ChuckTimber/SWer4x4/README.md

# SWer4x4

[3ループ・スイッチャ - DIY Fx and Synthesizer](https://scrapbox.io/diyfx/3%E3%83%AB%E3%83%BC%E3%83%97%E3%83%BB%E3%82%B9%E3%82%A4%E3%83%83%E3%83%81%E3%83%A3)

## 仕様

## 回路図

## 筐体
### テストベッド
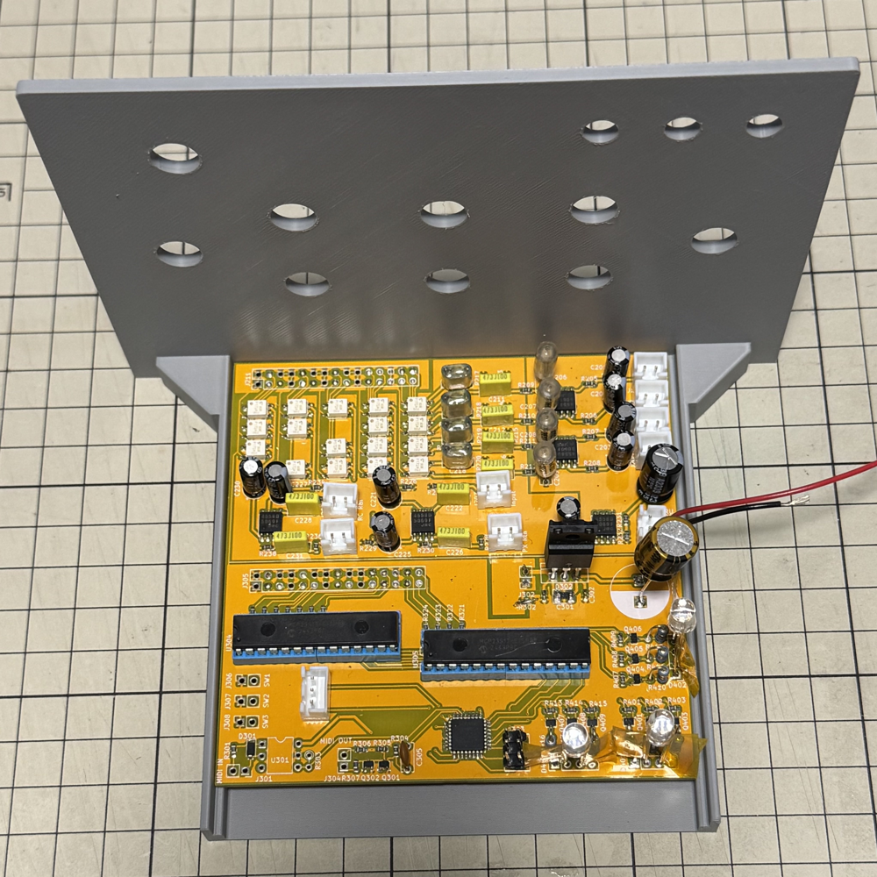
[picture p1: rsrc/testbed.png]
