ChuckTimber/SWer4x4/hardware/Enclosure/testbed/testbed_v2.FCStd

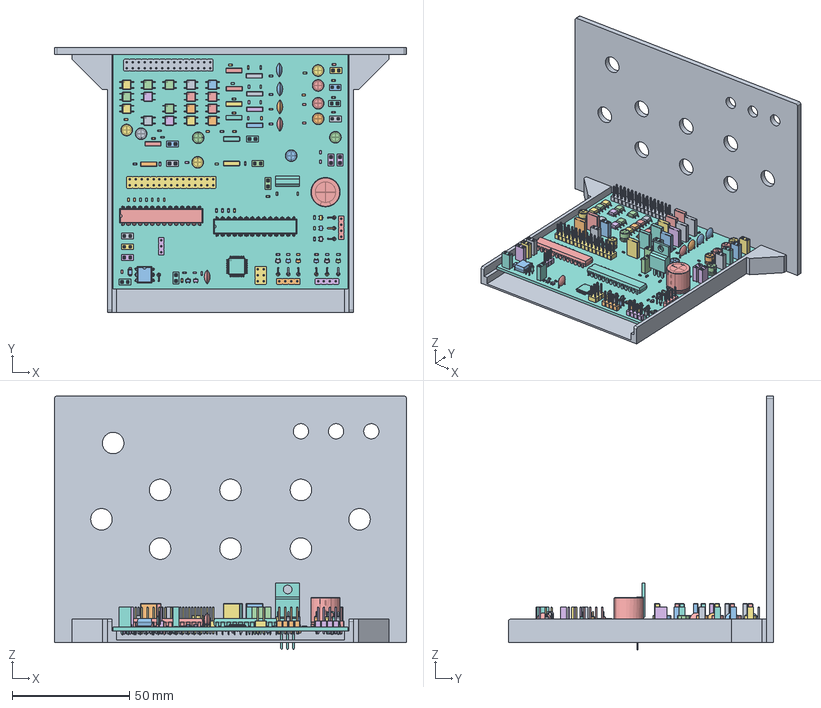
[picture p2: CAD file, 2026-01-19]
hardware/Enclosure/testbed/testbed_v2.FCStd
150.0 x 113.0 x 108.2 mm
R_0603_1608Metric
SOT-323_SC-70
R_0603_1608Metric001
CP_Radial_D12.5mm_P5.00mm
R_0603_1608Metric002
SOP-4_3.8x4.1mm_P2.54mm
PinSocket_1x02_P2.54mm_Vertical
R_0603_1608Metric003
C_Rect_L7.0mm_W2.0mm_P5.00mm
SOT-323_SC-071
SOP-4_3.8x4.1mm_P2.54mm001
C_Rect_L7.0mm_W2.0mm_P5.00mm001
R_0603_1608Metric004
R_Axial_DIN0204_L3.6mm_D1.6mm_P2.54mm_Vertical
R_Axial_DIN0204_L3.6mm_D1.6mm_P2.54mm_Vertical001
R_0603_1608Metric005
CP_Radial_D5.0mm_P2.00mm
R_0603_1608Metric006
SOT-323_SC-072
R_0603_1608Metric007
R_0603_1608Metric008
CP_Radial_D5.0mm_P2.00mm001
C_Rect_L7.0mm_W2.0mm_P5.00mm002
SOP-4_3.8x4.1mm_P2.54mm002
SOT-323_SC-073
R_Axial_DIN0204_L3.6mm_D1.6mm_P2.54mm_Vertical002
R_0603_1608Metric009
CP_Radial_D5.0mm_P2.00mm002
PinHeader_1x03_P2.54mm_Vertical
PinSocket_1x02_P2.54mm_Vertical001
R_0603_1608Metric010
R_0603_1608Metric011
R_0603_1608Metric012
C_Rect_L7.0mm_W2.0mm_P5.00mm003
R_0603_1608Metric013
C_Disc_D6.0mm_W2.5mm_P5.00mm
R_0603_1608Metric014
R_Axial_DIN0204_L3.6mm_D1.6mm_P2.54mm_Vertical003
PinSocket_1x02_P2.54mm_Vertical002
R_Axial_DIN0204_L3.6mm_D1.6mm_P2.54mm_Vertical004
C_Disc_D6.0mm_W2.5mm_P5.00mm001
SWer_matrix 1.42.1
SWer_matrix 1.42.002
SWer_matrix 1.42.003
SWer_matrix 1.42.004
R_0603_1608Metric015
R_0603_1608Metric016
C_Rect_L7.0mm_W2.0mm_P5.00mm004
R_0603_1608Metric017
R_0603_1608Metric018
PinSocket_1x02_P2.54mm_Vertical003
C_Rect_L7.0mm_W2.0mm_P5.00mm005
R_0603_1608Metric019
PinHeader_2x03_P2.54mm_Vertical
TQFP-32_7x7mm_P0.8mm
CP_Radial_D5.0mm_P2.00mm003
R_0603_1608Metric020
R_0603_1608Metric021
CP_Radial_D5.0mm_P2.00mm004
C_Rect_L7.0mm_W2.0mm_P5.00mm006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
