ChuckTimber/SWer4x4/hardware/Enclosure/testbed/testbed_v2-Body.3mf

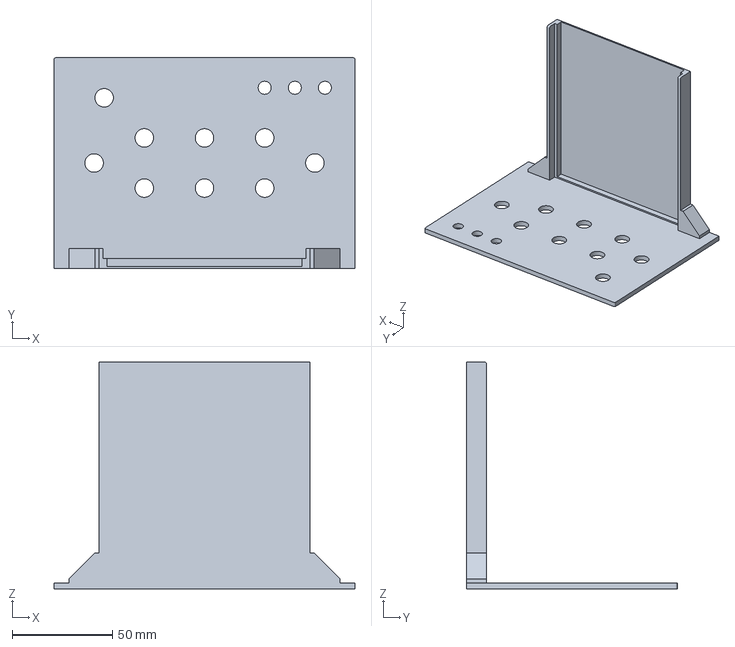
[picture p3: CAD file, 2026-01-19]
hardware/Enclosure/testbed/testbed_v2-Body.3mf
150.0 x 105.0 x 113.0 mm
