ChuckTimber/SWer4x4/(list of files, cad)

Other CAD files:
hardware/Enclosure/testbed/testbed_v2-Body.stl
