ChuckTimber/SWer4x4/hardware/SWer_matrix.pdf

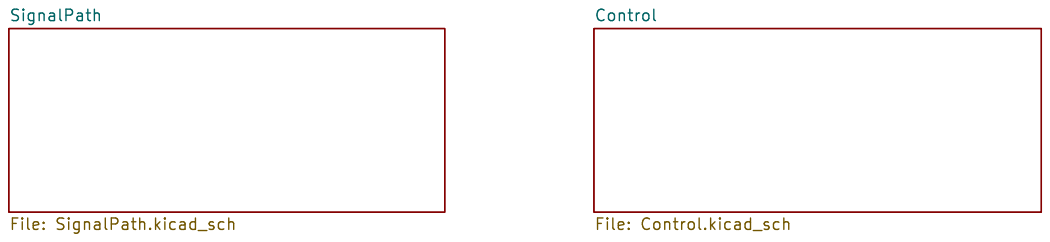
[picture p4: page 1]

Control File: Control.kicad_sch SignalPath File: SignalPath.kicad_sch

Id: 1/4 Title: Swticher Matrix 4x4

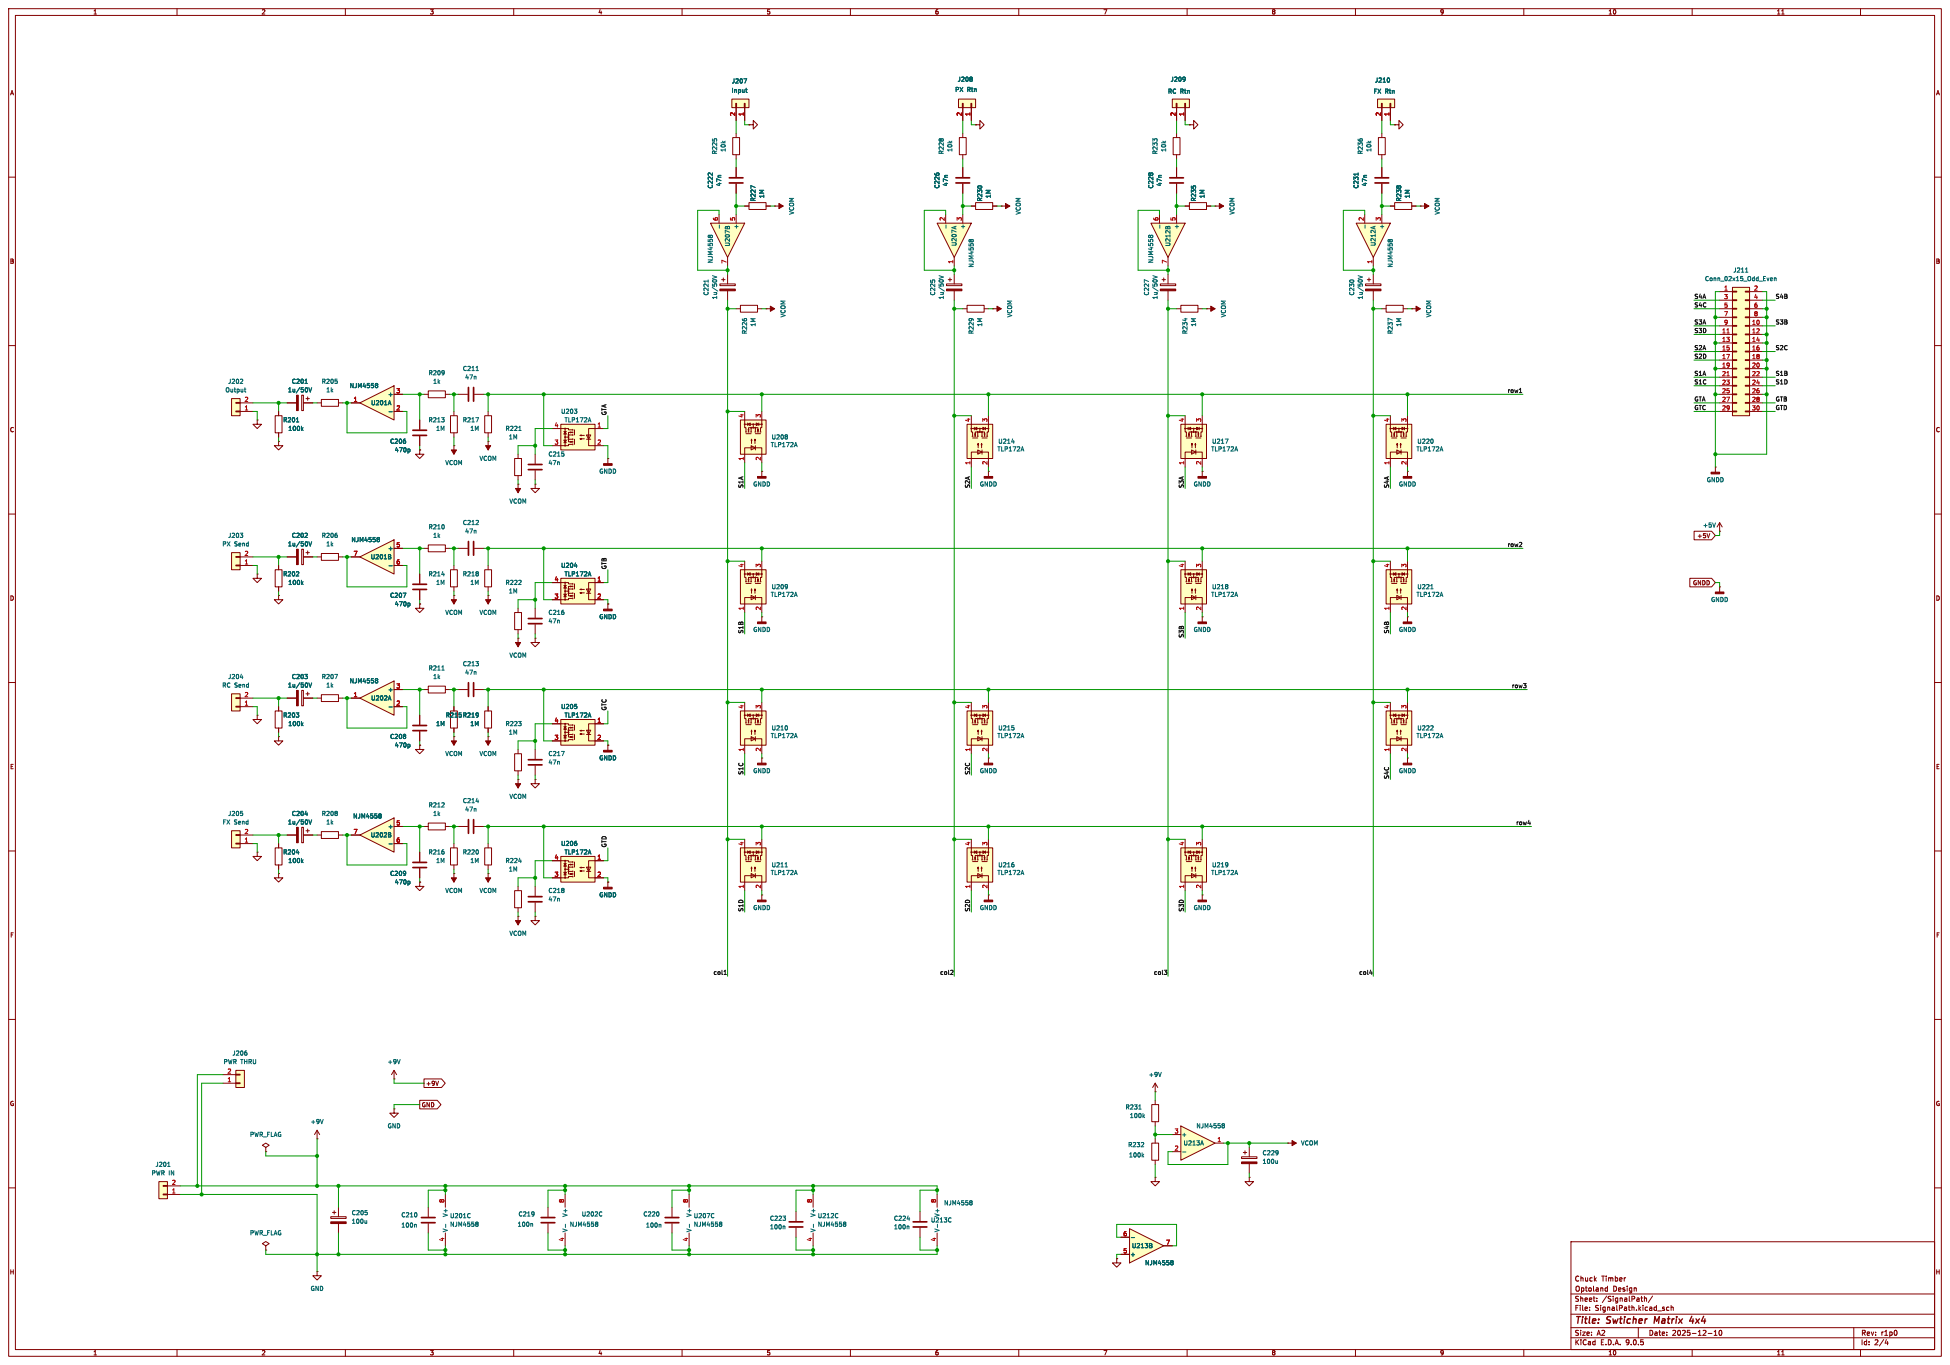
[picture p5: page 2]

File: SignalPath.kicad_sch Sheet: /SignalPath/

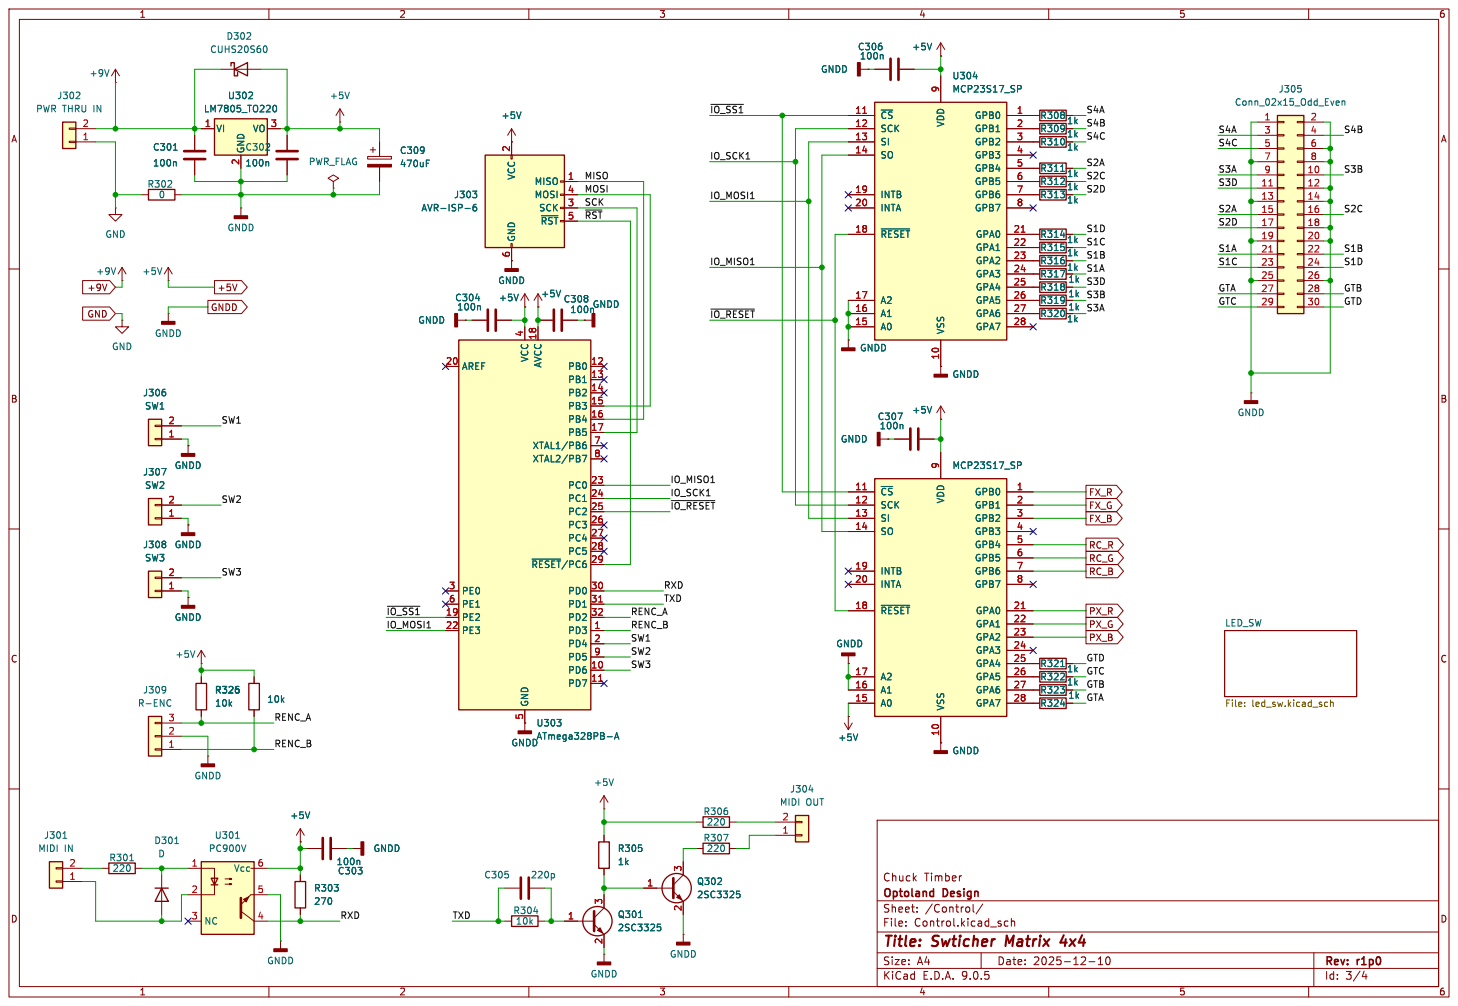
[picture p6: page 3]

6 MISO 1 MOSI 4 SCK 3 ~{RST}5 +5V C302

6 MISO 1 MOSI 4 SCK 3 ~{RST}5

5 AVCC 18 PB0 12 PB1 13 PB2 14 PB3 15 PB4 16 PB5 17 XTAL1/PB6 7 XTAL2/PB7 8 PC0 23 PC1 24 PC2 25 PC3 26 PC4 27 PC5 28 ~{RESET}/PC629 PD0 30 PD1 31 PD2 32 PD3 1 PD4 2 PD5 9 PD6 10 PD7 11 GNDD GNDD C308

Id: 3/4 Title: Swticher Matrix 4x4

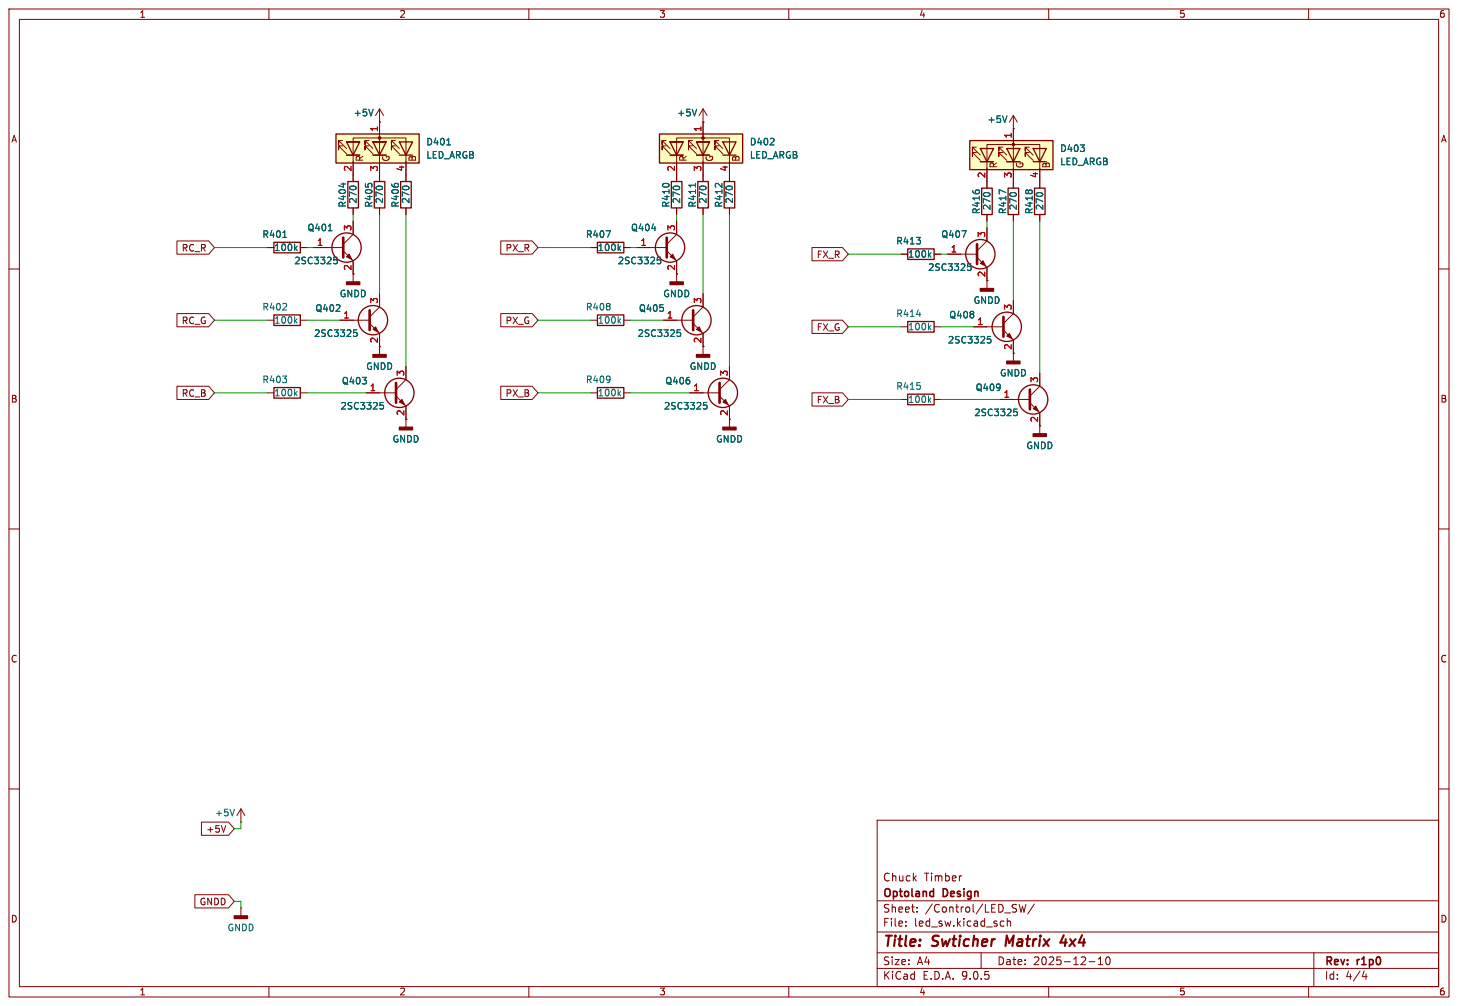
[picture p7: page 4]

File: led_sw.kicad_sch Sheet: /Control/LED_SW/
Id: 4/4 Title: Swticher Matrix 4x4
