ChuckTimber/SWer4x4/hardware/KiCAD/SWer_matrix.kicad_pcb

## KiCad design hardware/KiCAD/SWer_matrix.kicad_pcb (2026-01-19)

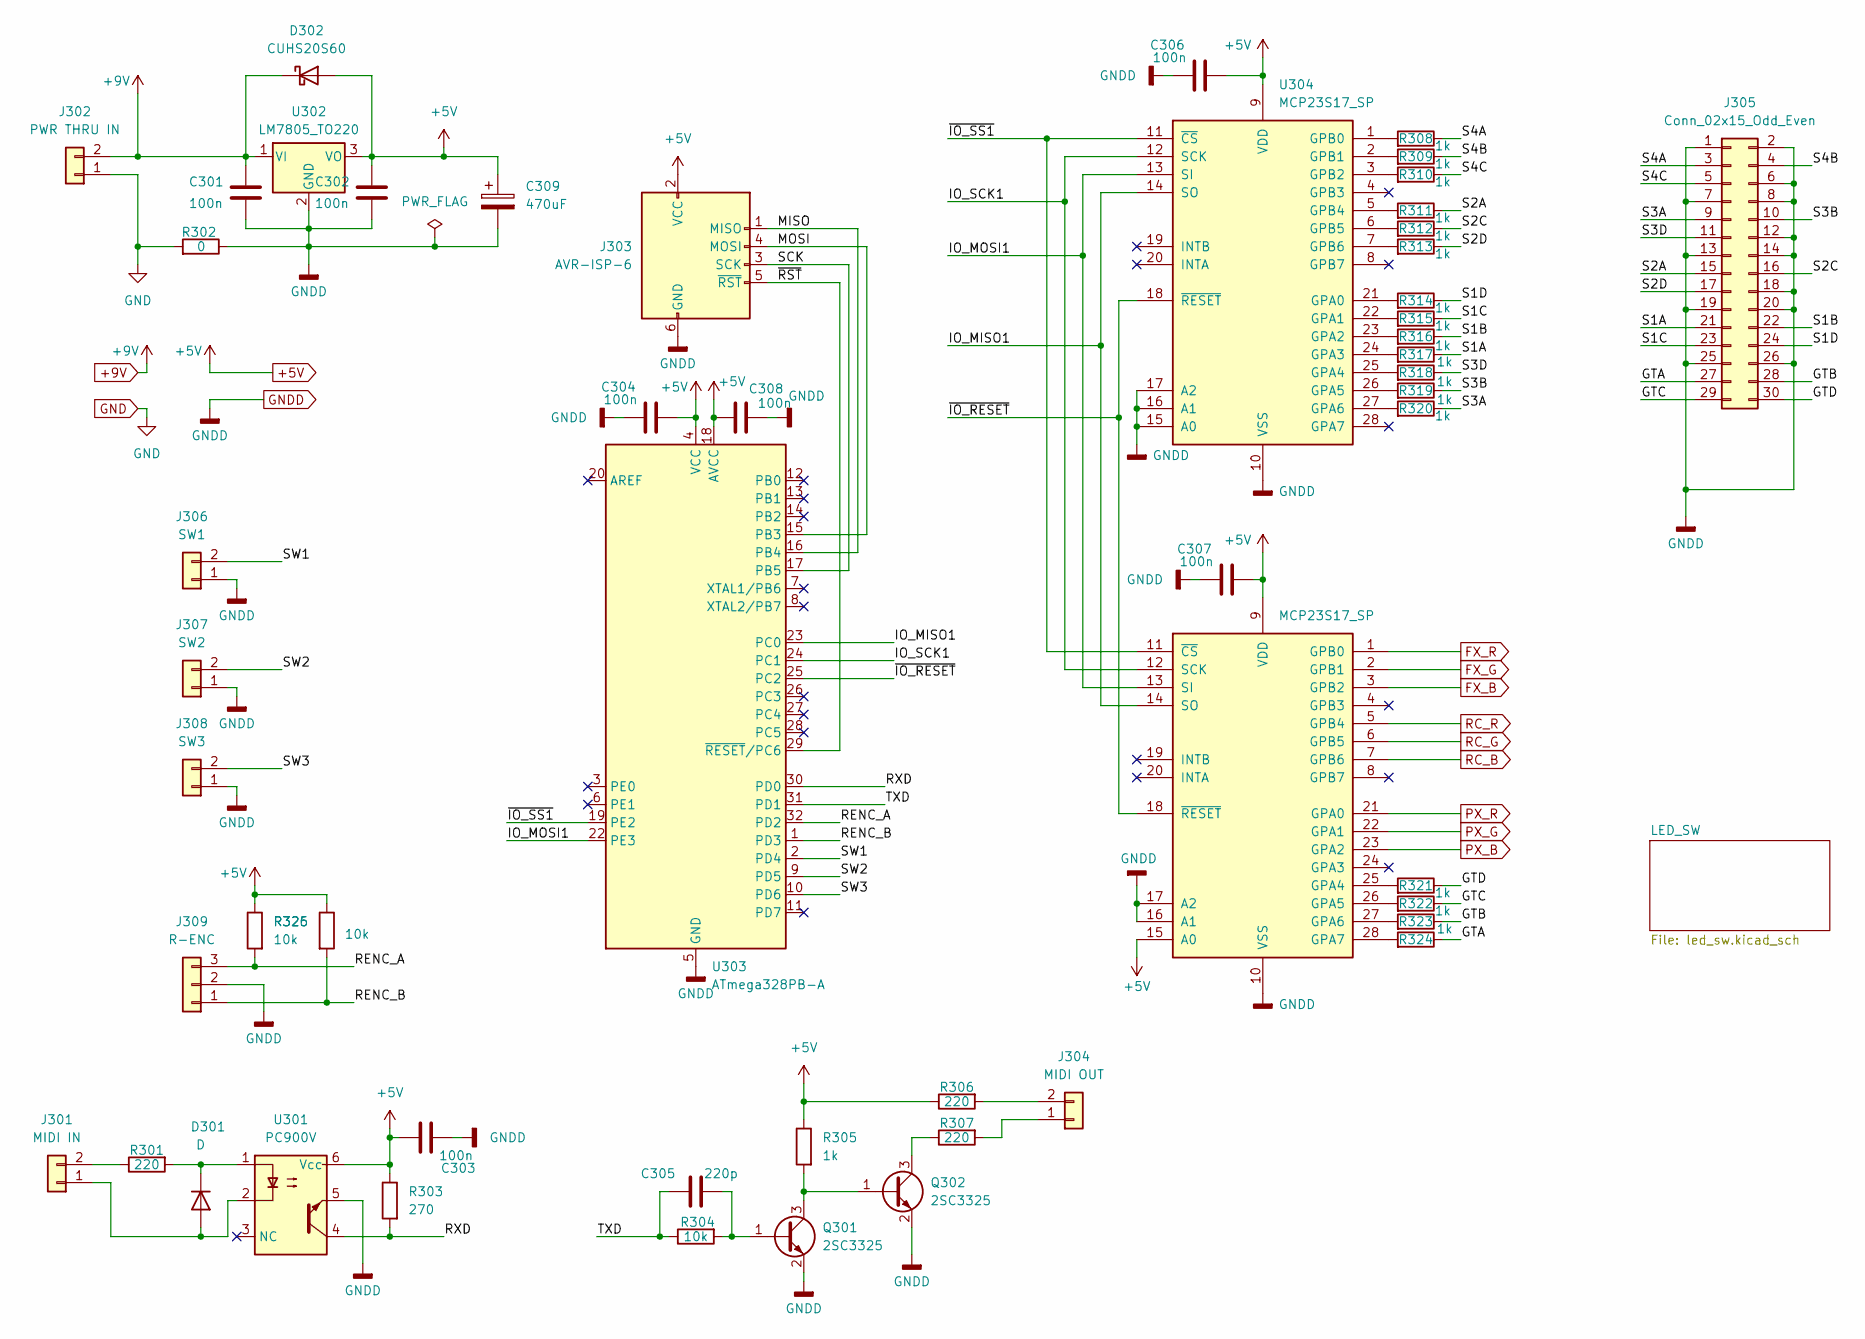
[picture p8: schematic Control.kicad_sch, Swticher Matrix 4x4]

Parts:
C301, C302, C303, C304, C306, C307, C308: 100n; C_0603_1608Metric_Pad1.08x0.95mm_HandSolder
C305: 220p; C_Disc_D6.0mm_W2.5mm_P5.00mm
C309: 470uF; CP_Radial_D12.5mm_P5.00mm
D301: D; Nexperia_CFP3_SOD-123W
D302: CUHS20S60; D_1210_3225Metric_Pad1.42x2.65mm_HandSolder
J301: MIDI IN; PinSocket_1x02_P2.54mm_Vertical
J302: PWR THRU IN; PinSocket_1x02_P2.54mm_Vertical
J303: AVR-ISP-6; PinHeader_2x03_P2.54mm_Vertical
J304: MIDI OUT; PinSocket_1x02_P2.54mm_Vertical
J305: Conn_02x15_Odd_Even; PinHeader_2x15_P2.54mm_Vertical
J306: SW1; PinSocket_1x02_P2.54mm_Vertical
J307: SW2; PinSocket_1x02_P2.54mm_Vertical
J308: SW3; PinSocket_1x02_P2.54mm_Vertical
J309: R-ENC; PinHeader_1x03_P2.54mm_Vertical
Q301, Q302: 2SC3325; SOT-323_SC-70
R301, R306, R307: 220; R_0603_1608Metric_Pad0.98x0.95mm_HandSolder
R302: 0; R_0603_1608Metric_Pad0.98x0.95mm_HandSolder
R303: 270; R_Axial_DIN0204_L3.6mm_D1.6mm_P2.54mm_Vertical
R304, R325, R326: 10k; R_0603_1608Metric_Pad0.98x0.95mm_HandSolder
R305, R308, R309, R310, R311, R312, R313, R314, R315, R316, R317, R318, R319, R320, R321, R322, R323, R324: 1k; R_0603_1608Metric_Pad0.98x0.95mm_HandSolder
U301: PC900V; DIP-6_W7.62mm
U302: LM7805_TO220; TO-220-3_Vertical
U303: ATmega328PB-A; TQFP-32_7x7mm_P0.8mm
U304, U305: MCP23S17_SP; DIP-28_W7.62mm

Connections:
+5V: C302.1, C303.2, C304.2, C306.2, C307.2, C308.2, C309.1, D302.2 (A), J303.2 (VCC), R303.1, R305.1, R306.1, R325.1, R326.1, U301.6 (Vcc), U302.3 (VO), U303.4 (VCC), U303.18 (AVCC), U304.9 (VDD), U305.9 (VDD), U305.15 (A0); also elsewhere on the board
+9V: C301.1, D302.1 (K), J302.2, U302.1 (VI); also elsewhere on the board
/Control/GTA: J305.27, R324.1
/Control/GTB: J305.28, R323.1
/Control/GTC: J305.29, R322.1
/Control/GTD: J305.30, R321.1
/Control/IO_MISO1: U303.23 (PC0), U304.14 (SO), U305.14 (SO)
/Control/IO_MOSI1: U303.22 (PE3), U304.13 (SI), U305.13 (SI)
/Control/IO_SCK1: U303.24 (PC1), U304.12 (SCK), U305.12 (SCK)
/Control/MISO: J303.1 (MISO), U303.16 (PB4)
/Control/MOSI: J303.4 (MOSI), U303.15 (PB3)
/Control/RENC_A: J309.3, R325.2, U303.32 (PD2)
/Control/RENC_B: J309.1, R326.2, U303.1 (PD3)
/Control/RXD: R303.2, U301.4, U303.30 (PD0)
/Control/S1A: J305.21, R317.1
/Control/S1B: J305.22, R316.1
/Control/S1C: J305.23, R315.1
/Control/S1D: J305.24, R314.1
/Control/S2A: J305.15, R311.1
/Control/S2C: J305.16, R312.1
/Control/S2D: J305.17, R313.1
/Control/S3A: J305.9, R320.1
/Control/S3B: J305.10, R319.1
/Control/S3D: J305.11, R318.1
/Control/S4A: J305.3, R308.1
/Control/S4B: J305.4, R309.1
/Control/S4C: J305.5, R310.1
/Control/SCK: J303.3 (SCK), U303.17 (PB5)
/Control/SW1: J306.2, U303.2 (PD4)
/Control/SW2: J307.2, U303.9 (PD5)
/Control/SW3: J308.2, U303.10 (PD6)
/Control/TXD: C305.1, R304.1, U303.31 (PD1)
/Control/~IO_RESET: U303.25 (PC2), U304.18 (~RESET), U305.18 (~RESET)
/Control/~IO_SS1: U303.19 (PE2), U304.11 (~CS), U305.11 (~CS)
/Control/~RST: J303.5 (~RST), U303.29 (~RESET/PC6)
FX_B: U305.3 (GPB2); also elsewhere on the board
FX_G: U305.2 (GPB1); also elsewhere on the board
FX_R: U305.1 (GPB0); also elsewhere on the board
GND: J302.1, R302.2; also elsewhere on the board
GNDD: C301.2, C302.2, C303.1, C304.1, C306.1, C307.1, C308.1, C309.2, J303.6 (GND), J305.1, J305.2, J305.6, J305.7, J305.8, J305.12, J305.13, J305.14, J305.18, J305.19, J305.20, J305.25, J305.26, J306.1, J307.1, J308.1, J309.2, Q301.2 (E), Q302.2 (E), R302.1, U301.5, U302.2 (GND), U303.5 (GND), U303.21 (GND), U304.10 (VSS), U304.15 (A0), U304.16 (A1), U304.17 (A2), U305.10 (VSS), U305.16 (A1), U305.17 (A2); also elsewhere on the board
unnamed: D301.2 (A), J301.1, U301.2
unnamed: D301.1 (K), R301.2, U301.1
unnamed: J301.2, R301.1
unnamed: J304.1, R307.2
unnamed: J304.2, R306.2
unnamed: C305.2, Q301.1 (B), R304.2
unnamed: Q301.3 (C), Q302.1 (B), R305.2
unnamed: Q302.3 (C), R307.1
unnamed: R314.2, U304.21 (GPA0)
unnamed: R315.2, U304.22 (GPA1)
unnamed: R316.2, U304.23 (GPA2)
unnamed: R317.2, U304.24 (GPA3)
unnamed: R318.2, U304.25 (GPA4)
unnamed: R319.2, U304.26 (GPA5)
unnamed: R320.2, U304.27 (GPA6)
unnamed: R308.2, U304.1 (GPB0)
unnamed: R309.2, U304.2 (GPB1)
unnamed: R310.2, U304.3 (GPB2)
unnamed: R311.2, U304.5 (GPB4)
unnamed: R312.2, U304.6 (GPB5)
unnamed: R313.2, U304.7 (GPB6)
unnamed: R321.2, U305.25 (GPA4)
unnamed: R322.2, U305.26 (GPA5)
unnamed: R323.2, U305.27 (GPA6)
unnamed: R324.2, U305.28 (GPA7)
PX_B: U305.23 (GPA2); also elsewhere on the board
PX_G: U305.22 (GPA1); also elsewhere on the board
PX_R: U305.21 (GPA0); also elsewhere on the board
RC_B: U305.7 (GPB6); also elsewhere on the board
RC_G: U305.6 (GPB5); also elsewhere on the board
RC_R: U305.5 (GPB4); also elsewhere on the board

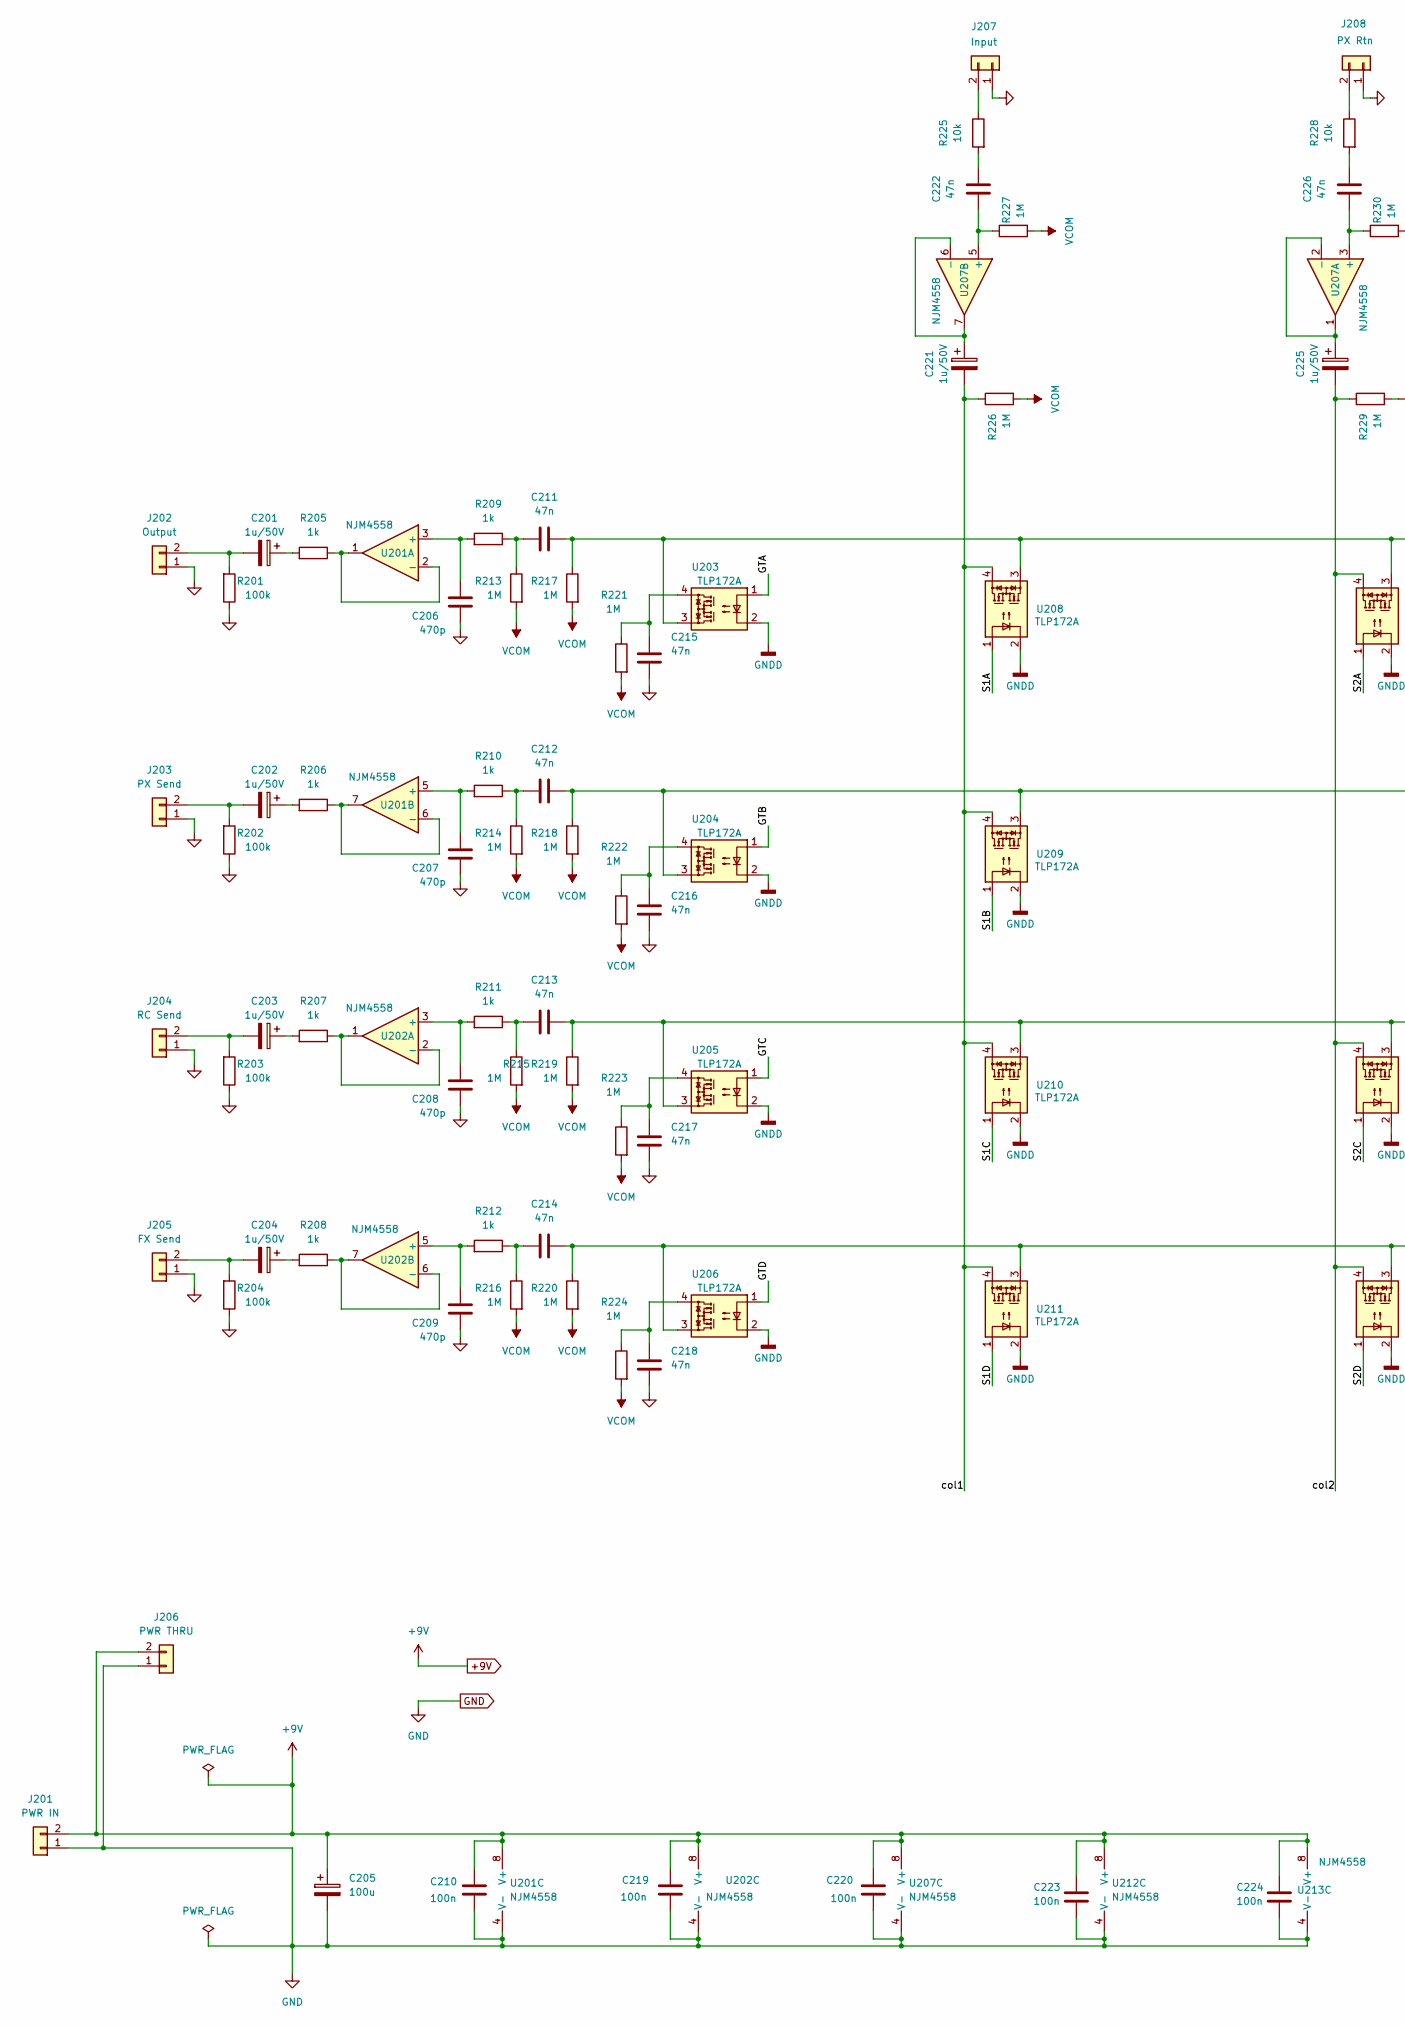
[picture p9: schematic SignalPath.kicad_sch, Swticher Matrix 4x4, part in row 1, column 1]

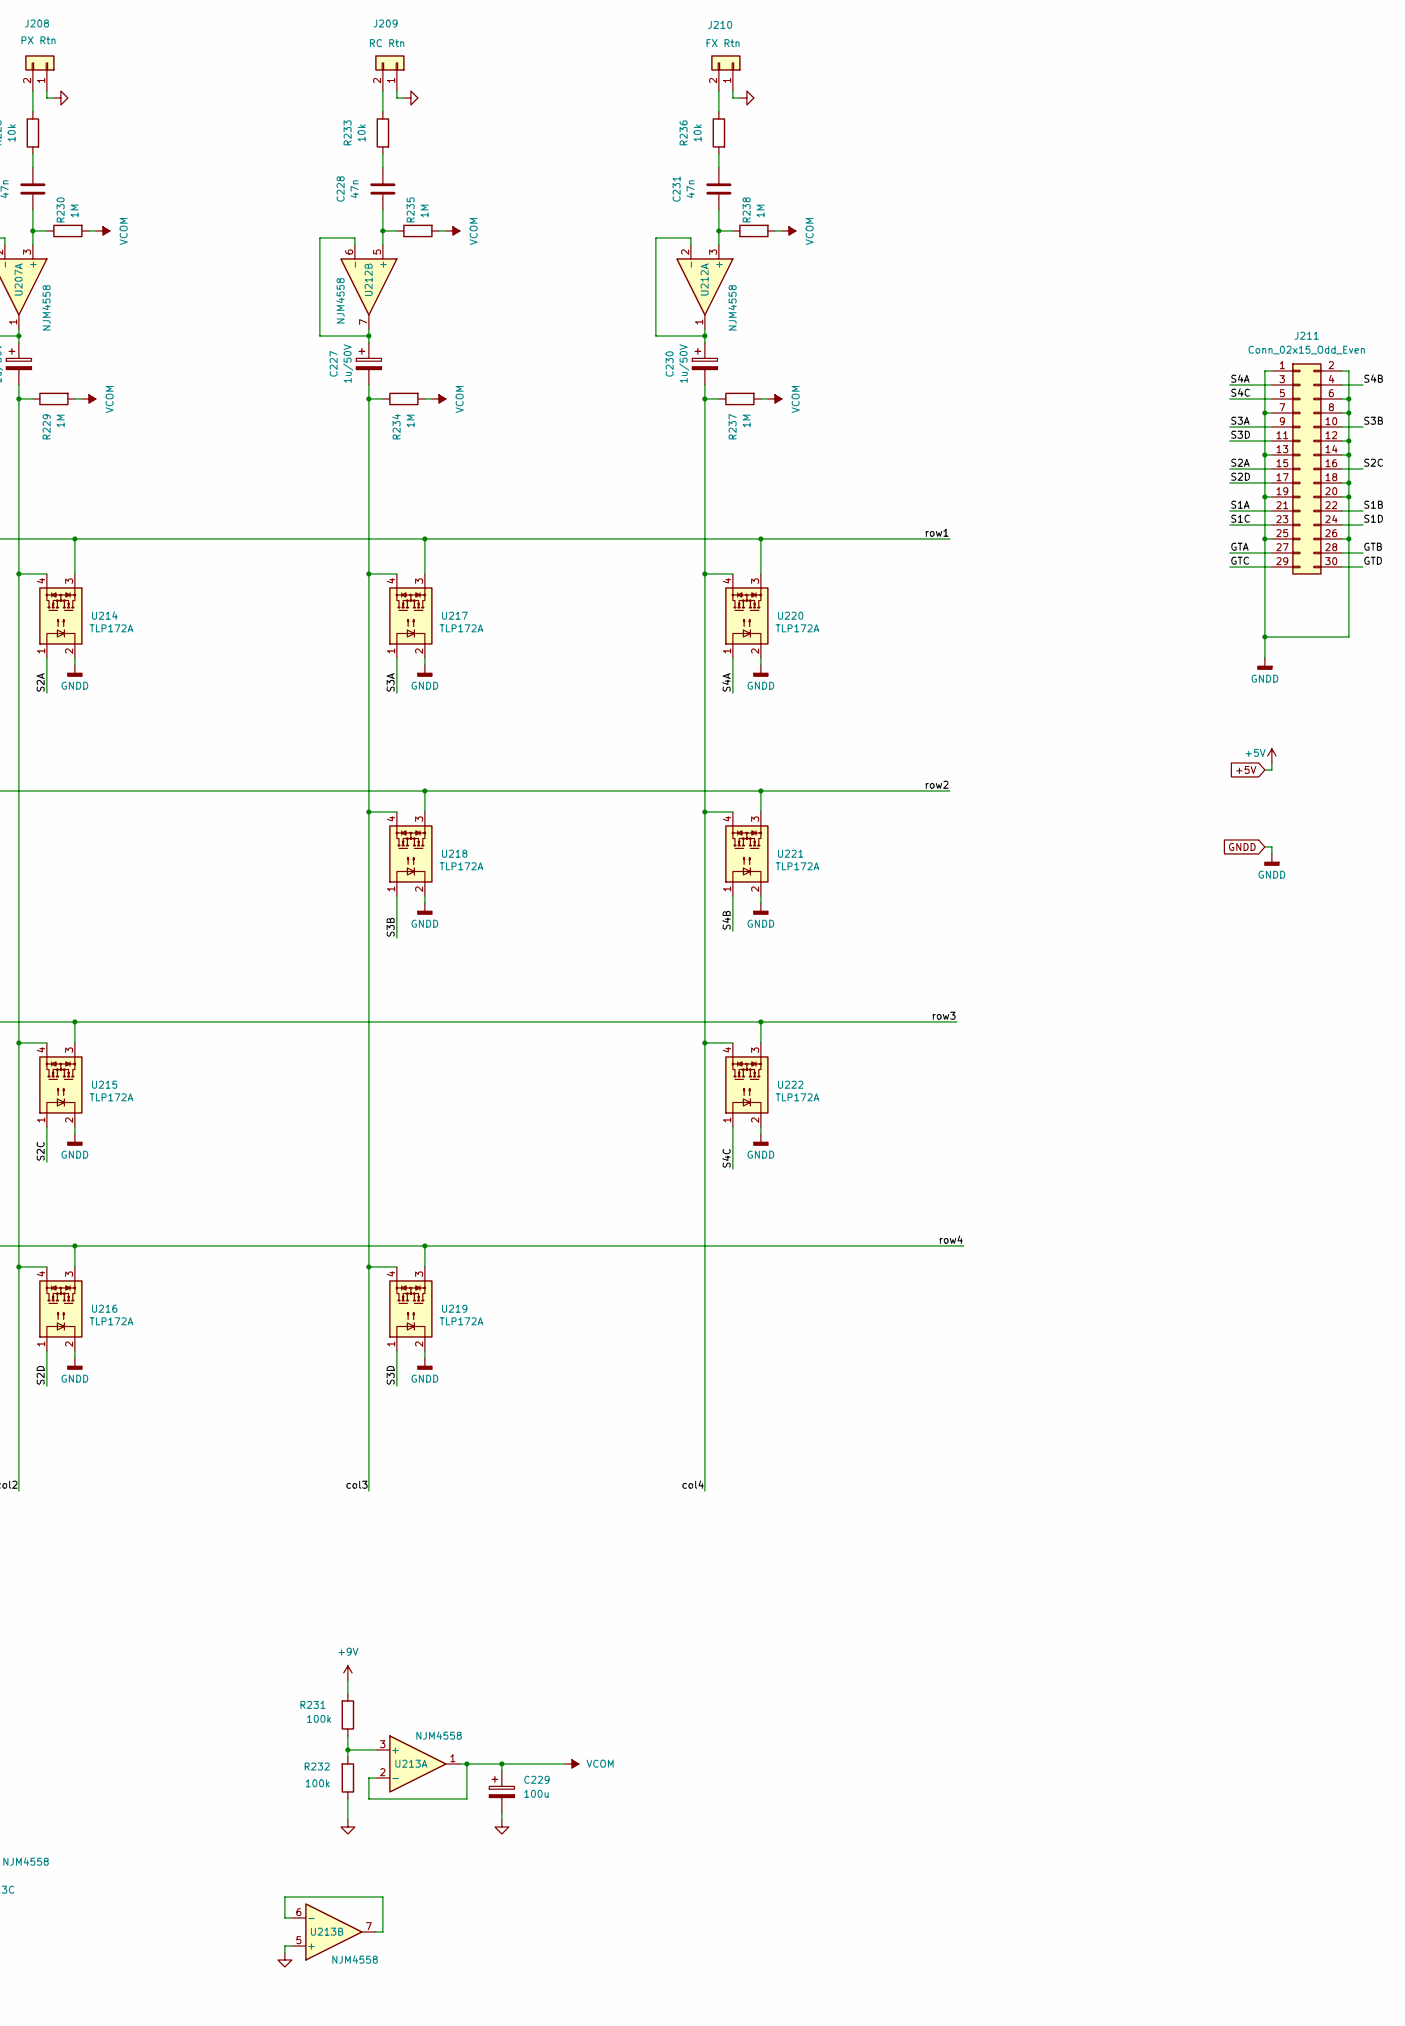
[picture p10: schematic SignalPath.kicad_sch, Swticher Matrix 4x4, part in row 1, column 2]

Parts:
C201, C202, C203, C204, C221, C225, C227, C230: 1u/50V; CP_Radial_D5.0mm_P2.00mm
C205, C229: 100u; CP_Radial_D5.0mm_P2.00mm
C206, C207, C208, C209: 470p; C_Disc_D6.0mm_W2.5mm_P5.00mm
C210, C219, C220, C223, C224: 100n; C_0603_1608Metric_Pad1.08x0.95mm_HandSolder
C211, C212, C213, C214, C215, C216, C217, C218, C222, C226, C228, C231: 47n; C_Rect_L7.0mm_W2.0mm_P5.00mm
J201: PWR IN; PinSocket_1x02_P2.54mm_Vertical
J202: Output; PinSocket_1x02_P2.54mm_Vertical
J203: PX Send; PinSocket_1x02_P2.54mm_Vertical
J204: RC Send; PinSocket_1x02_P2.54mm_Vertical
J205: FX Send; PinSocket_1x02_P2.54mm_Vertical
J206: PWR THRU; PinSocket_1x02_P2.54mm_Vertical
J207: Input; PinSocket_1x02_P2.54mm_Vertical
J208: PX Rtn; PinSocket_1x02_P2.54mm_Vertical
J209: RC Rtn; PinSocket_1x02_P2.54mm_Vertical
J210: FX Rtn; PinSocket_1x02_P2.54mm_Vertical
J211: Conn_02x15_Odd_Even; PinHeader_2x15_P2.54mm_Vertical
R201, R202, R203, R204, R231, R232: 100k; R_0603_1608Metric_Pad0.98x0.95mm_HandSolder
R205, R206, R207, R208, R209, R210, R211, R212: 1k; R_0603_1608Metric_Pad0.98x0.95mm_HandSolder
R213, R214, R215, R216, R217, R218, R219, R220, R221, R222, R223, R224, R226, R227, R229, R230, R234, R235, R237, R238: 1M; R_0603_1608Metric_Pad0.98x0.95mm_HandSolder
R225, R228, R233, R236: 10k; R_0603_1608Metric_Pad0.98x0.95mm_HandSolder
U201, U202, U207, U212, U213: NJM4558; DMP-8_P1.27mm_HandSolder
U203, U204, U205, U206, U208, U209, U210, U211, U214, U215, U216, U217, U218, U219, U220, U221, U222: TLP172A; SOP-4_3.8x4.1mm_P2.54mm

Connections:
+9V: C205.1, C210.1, C219.1, C220.1, C223.1, C224.1, J201.2, J206.2, R231.2, U201.8 (V+), U202.8 (V+), U207.8 (V+), U212.8 (V+), U213.8 (V+); also elsewhere on the board
/SignalPath/GTA: J211.27, U203.1
/SignalPath/GTB: J211.28, U204.1
/SignalPath/GTC: J211.29, U205.1
/SignalPath/GTD: J211.30, U206.1
/SignalPath/S1A: J211.21, U208.1
/SignalPath/S1B: J211.22, U209.1
/SignalPath/S1C: J211.23, U210.1
/SignalPath/S1D: J211.24, U211.1
/SignalPath/S2A: J211.15, U214.1
/SignalPath/S2C: J211.16, U215.1
/SignalPath/S2D: J211.17, U216.1
/SignalPath/S3A: J211.9, U217.1
/SignalPath/S3B: J211.10, U218.1
/SignalPath/S3D: J211.11, U219.1
/SignalPath/S4A: J211.3, U220.1
/SignalPath/S4B: J211.4, U221.1
/SignalPath/S4C: J211.5, U222.1
/SignalPath/col1: C221.2, R226.1, U208.4, U209.4, U210.4, U211.4
/SignalPath/col2: C225.2, R229.1, U214.4, U215.4, U216.4
/SignalPath/col3: C227.2, R234.1, U217.4, U218.4, U219.4
/SignalPath/col4: C230.2, R237.1, U220.4, U221.4, U222.4
/SignalPath/row1: C211.1, R217.1, U203.3, U208.3, U214.3, U217.3, U220.3
/SignalPath/row2: C212.2, R218.1, U204.3, U209.3, U218.3, U221.3
/SignalPath/row3: C213.1, R219.1, U205.3, U210.3, U215.3, U222.3
/SignalPath/row4: C214.1, R220.1, U206.3, U211.3, U216.3, U219.3
GND: C205.2, C206.2, C207.2, C208.2, C209.2, C210.2, C215.2, C216.2, C217.2, C218.2, C219.2, C220.2, C223.2, C224.2, C229.2, J201.1, J202.1, J203.1, J204.1, J205.1, J206.1, J207.1, J208.1, J209.1, J210.1, R201.1, R202.1, R203.1, R204.1, R232.1, U201.4 (V-), U202.4 (V-), U207.4 (V-), U212.4 (V-), U213.4 (V-), U213.5 (+); also elsewhere on the board
GNDD: J211.1, J211.2, J211.6, J211.7, J211.8, J211.12, J211.13, J211.14, J211.18, J211.19, J211.20, J211.25, J211.26, U203.2, U204.2, U205.2, U206.2, U208.2, U209.2, U210.2, U211.2, U214.2, U215.2, U216.2, U217.2, U218.2, U219.2, U220.2, U221.2, U222.2; also elsewhere on the board
unnamed: C201.1, R205.2
unnamed: C202.1, R206.2
unnamed: C203.1, R207.2
unnamed: C204.1, R208.2
unnamed: C211.2, R209.1, R213.1
unnamed: C212.1, R210.1, R214.1
unnamed: C213.2, R211.1, R215.1
unnamed: C214.2, R212.1, R216.1
unnamed: C215.1, R221.1, U203.4
unnamed: C216.1, R222.1, U204.4
unnamed: C217.1, R223.1, U205.4
unnamed: C218.1, R224.1, U206.4
unnamed: C222.1, R225.2
unnamed: C226.1, R228.2
unnamed: C228.1, R233.2
unnamed: C231.1, R236.2
unnamed: C201.2, J202.2, R201.2
unnamed: C202.2, J203.2, R202.2
unnamed: C203.2, J204.2, R203.2
unnamed: C204.2, J205.2, R204.2
unnamed: J207.2, R225.1
unnamed: J208.2, R228.1
unnamed: J209.2, R233.1
unnamed: J210.2, R236.1
unnamed: C206.1, R209.2, U201.3 (+)
unnamed: R205.1, U201.1, U201.2 (-)
unnamed: C207.1, R210.2, U201.5 (+)
unnamed: R206.1, U201.6 (-), U201.7
unnamed: C208.1, R211.2, U202.3 (+)
unnamed: R207.1, U202.1, U202.2 (-)
unnamed: C209.1, R212.2, U202.5 (+)
unnamed: R208.1, U202.6 (-), U202.7
unnamed: C226.2, R230.1, U207.3 (+)
unnamed: C225.1, U207.1, U207.2 (-)
unnamed: C222.2, R227.1, U207.5 (+)
unnamed: C221.1, U207.6 (-), U207.7
unnamed: C231.2, R238.1, U212.3 (+)
unnamed: C230.1, U212.1, U212.2 (-)
unnamed: C228.2, R235.1, U212.5 (+)
unnamed: C227.1, U212.6 (-), U212.7
unnamed: R231.1, R232.2, U213.3 (+)
unnamed: U213.6 (-), U213.7
VCOM: C229.1, R213.2, R214.2, R215.2, R216.2, R217.2, R218.2, R219.2, R220.2, R221.2, R222.2, R223.2, R224.2, R226.2, R227.2, R229.2, R230.2, R234.2, R235.2, R237.2, R238.2, U213.1, U213.2 (-)

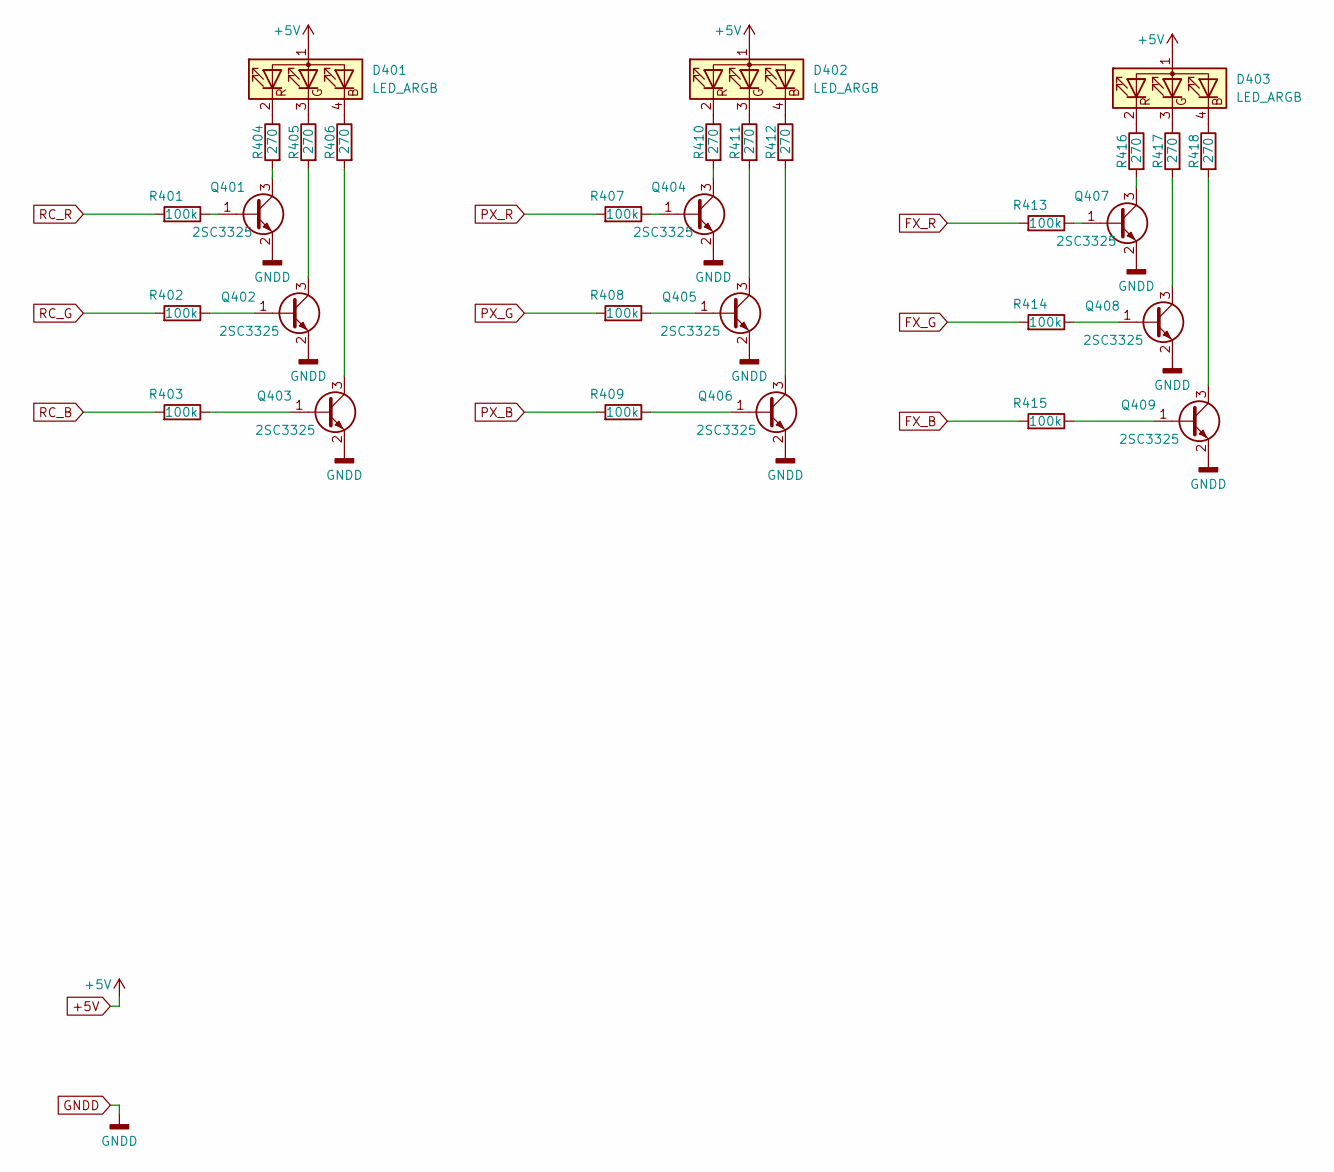
[picture p11: schematic led_sw.kicad_sch, Swticher Matrix 4x4]

Parts:
D401, D402, D403: LED_ARGB; PinHeader_1x04_P2.54mm_Vertical
Q401, Q402, Q403, Q404, Q405, Q406, Q407, Q408, Q409: 2SC3325; SOT-323_SC-70
R401, R402, R403, R407, R408, R409, R413, R414, R415: 100k; R_0603_1608Metric_Pad0.98x0.95mm_HandSolder
R404, R405, R406, R410, R411, R412, R416, R417, R418: 270; R_Axial_DIN0204_L3.6mm_D1.6mm_P2.54mm_Vertical

Connections:
+5V: D401.1 (A), D402.1 (A), D403.1 (A); also elsewhere on the board
FX_B: R415.2; also elsewhere on the board
FX_G: R414.2; also elsewhere on the board
FX_R: R413.2; also elsewhere on the board
GNDD: Q401.2 (E), Q402.2 (E), Q403.2 (E), Q404.2 (E), Q405.2 (E), Q406.2 (E), Q407.2 (E), Q408.2 (E), Q409.2 (E); also elsewhere on the board
unnamed: D401.4 (BK), R406.1
unnamed: D401.3 (GK), R405.1
unnamed: D401.2 (RK), R404.1
unnamed: D402.4 (BK), R412.1
unnamed: D402.3 (GK), R411.1
unnamed: D402.2 (RK), R410.1
unnamed: D403.4 (BK), R418.1
unnamed: D403.3 (GK), R417.1
unnamed: D403.2 (RK), R416.1
unnamed: Q401.1 (B), R401.1
unnamed: Q401.3 (C), R404.2
unnamed: Q402.1 (B), R402.1
unnamed: Q402.3 (C), R405.2
unnamed: Q403.1 (B), R403.1
unnamed: Q403.3 (C), R406.2
unnamed: Q404.1 (B), R407.1
unnamed: Q404.3 (C), R410.2
unnamed: Q405.1 (B), R408.1
unnamed: Q405.3 (C), R411.2
unnamed: Q406.1 (B), R409.1
unnamed: Q406.3 (C), R412.2
unnamed: Q407.1 (B), R413.1
unnamed: Q407.3 (C), R416.2
unnamed: Q408.1 (B), R414.1
unnamed: Q408.3 (C), R417.2
unnamed: Q409.1 (B), R415.1
unnamed: Q409.3 (C), R418.2
PX_B: R409.2; also elsewhere on the board
PX_G: R408.2; also elsewhere on the board
PX_R: R407.2; also elsewhere on the board
RC_B: R403.2; also elsewhere on the board
RC_G: R402.2; also elsewhere on the board
RC_R: R401.2; also elsewhere on the board

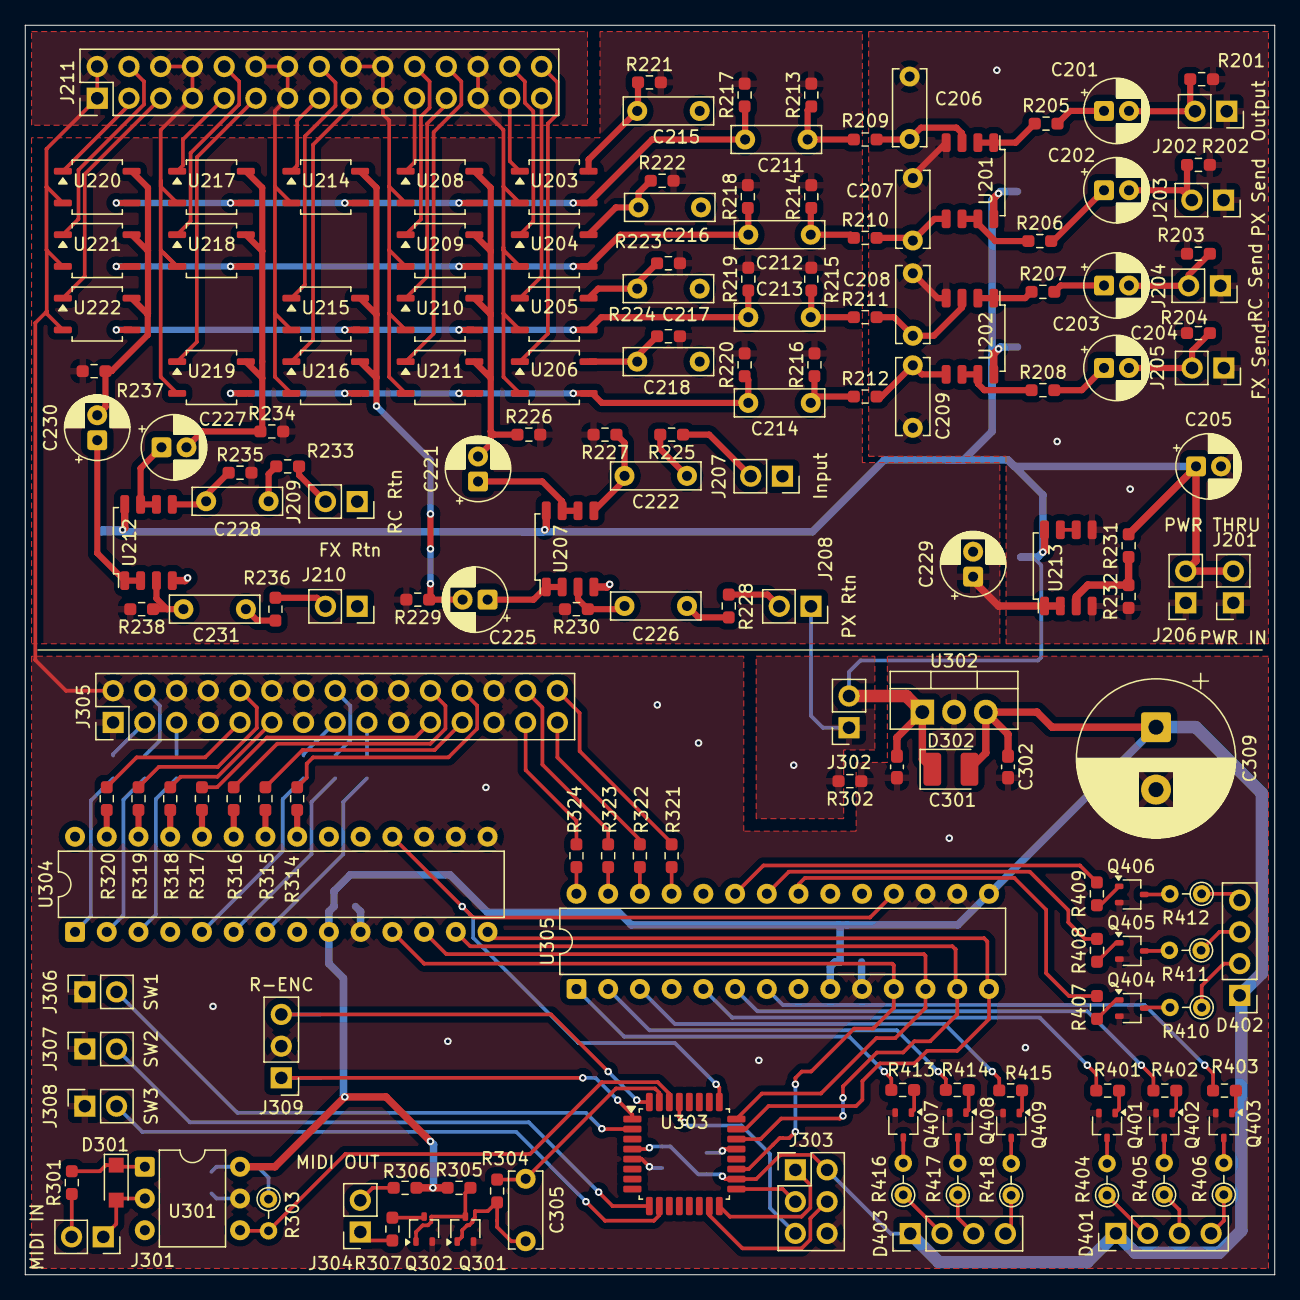
[picture p12: board SWer_matrix.kicad_pcb from above]

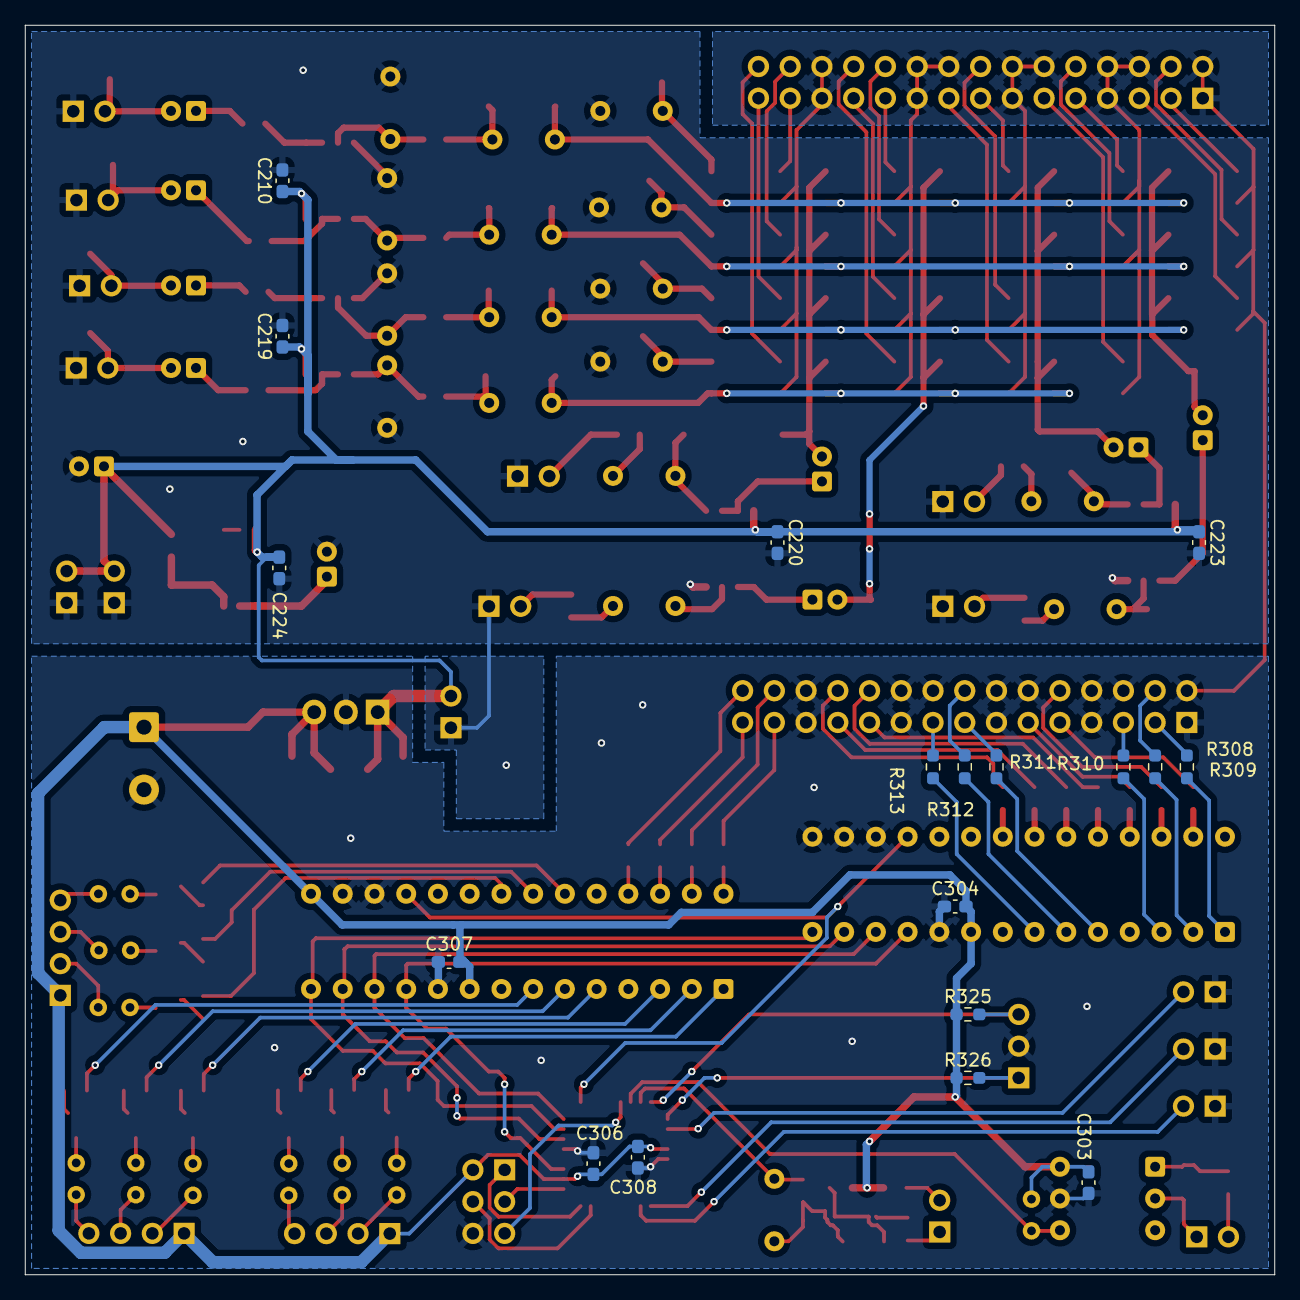
[picture p13: board SWer_matrix.kicad_pcb from below]

Board: 2 copper layers, 100.0 x 100.0 mm, 185 parts (18 on the bottom side), 166 nets.
