ChuckTimber/SWer4x4/firmware/SW4x4/timer.h

/*
 * timer.h
 *
 * Created: 2026/01/14 10:21:50
 *  Author: Chuck
 */ 


#ifndef TIMER_H_
#define TIMER_H_

void timer0Init(void);
bool getTM0Flg( void );
uint8_t getTM0Cnt( void );


#endif /* TIMER_H_ */
