ChuckTimber/SWer4x4/(commit log)

2026-01-19 File addition.
    [Control.kicad_sch, SWer_matrix.kicad_pcb, SWer_matrix.kicad_sch, SignalPath.kicad_sch, led_sw.kicad_sch, testbed_v2-Body.3mf, testbed_v2-Body.stl]
2026-01-19 Added a FreeCAD file.
    [testbed_v2.FCStd]
